AlperYaanik/STM32-Based-CAN-Bus-Communication-Interface/f401_mcp2515_node/f401_mcp2515_node.ioc

Mcu.UserName=STM32F401CCUx
PA10.Signal=USART1_RX
PA13.Signal=SYS_JTMS-SWDIO
PA14.Signal=SYS_JTCK-SWCLK
PA4.Signal=GPIO_Output
PA5.Signal=SPI1_SCK
PA6.Signal=SPI1_MISO
PA7.Signal=SPI1_MOSI
PA9.Signal=USART1_TX
PB0.GPIO_Label=MCP2515_INT
PB0.Signal=GPXTI0
PB6.Signal=I2C1_SCL
PB7.Signal=I2C1_SDA
PC13-ANTI_TAMP.Signal=GPIO_Output
