AlperYaanik/STM32-Based-CAN-Bus-Communication-Interface/f103_can_loopback/Core/Src/main.c

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
/* Includes ------------------------------------------------------------------*/
#include "main.h"
#include "can.h"
#include "usart.h"
#include "gpio.h"

/* USER CODE BEGIN Includes */
#include <stdio.h>
#include <string.h>
/* USER CODE END Includes */

/* USER CODE BEGIN PM */
#define CAN_TIMEOUT_MS 100
/* USER CODE END PM */


void SystemClock_Config(void);
/**
  * @brief  The application entry point.
  * @retval int
  */
int main(void)
{

  /* MCU Configuration--------------------------------------------------------*/

  /* Reset of all peripherals, Initializes the Flash interface and the Systick. */
  HAL_Init();

  /* Configure the system clock */
  SystemClock_Config();

  /* Initialize all configured peripherals */
  MX_GPIO_Init();
  MX_CAN_Init();
  MX_USART1_UART_Init();
  /* USER CODE BEGIN 2 */

  //Can Filter Configuration
    //Loopback Mode Filter Configuration and Selecting Filter Bank (0-13)
    CAN_FilterTypeDef canFilterConfig;
    canFilterConfig.FilterBank = 0;
    //ID Mask Mode (for easy usages , ID list for betwwen specified intervals) and 32-bit scale configuration (for standard and extended IDs)
    canFilterConfig.FilterMode = CAN_FILTERMODE_IDMASK;
    canFilterConfig.FilterScale = CAN_FILTERSCALE_32BIT;
    //Accept All Id (ie. 0x123<<5 for IMU sensor)
    canFilterConfig.FilterIdHigh = 0x0000;
    canFilterConfig.FilterIdLow= 0x0000;
    canFilterConfig.FilterMaskIdHigh = 0x0000;
    canFilterConfig.FilterMaskIdLow = 0x0000;
    //Convention, one FIFO is enough for loopback mode, so we can use FIFO0
    canFilterConfig.FilterFIFOAssignment = CAN_FILTER_FIFO0;
    //Must to ENABLE Filter Activation, otherwise the filter will not work
    canFilterConfig.FilterActivation = ENABLE;
    //Have to configure for Dual CAN board. STM32F103 has only one, but have to filled because of the structure.
    //So, we can use 14 for SlaveStartFilterBank (0-13 for Master, 14-27 for Slave)
    canFilterConfig.SlaveStartFilterBank = 14;
    //Error Handling (HAL_OK = 0, HAL_ERROR = 1, HAL_BUSY = 2, HAL_TIMEOUT = 3), important for debugging
    if (HAL_CAN_ConfigFilter(&hcan, &canFilterConfig) != HAL_OK)
    {
      Error_Handler();
    }
    //Start CAN Peripheral
    if(HAL_CAN_Start(&hcan)!=HAL_OK)
    {
      Error_Handler();
    }


    //Message Envelope Tx Configuration
    CAN_TxHeaderTypeDef TxHeader ={0};
    uint32_t TxMailbox;
    //We can send 8 bytes of data
    uint8_t TxData[8];
    //Standard ID (11 bits) for the message, 0x123 is a common ID for testing
    TxHeader.StdId = 0x123;
    //Extended ID (29 bits) is not used, so we can set it to 0
    TxHeader.ExtId = 0x00;
    //Standard ID is used, so we can set the IDE to CAN_ID_STD
    TxHeader.IDE = CAN_ID_STD;
    //Data Frame is used, so we can set the RTR to CAN_RTR_DATA
    TxHeader.RTR = CAN_RTR_DATA;
    //Selecting Bytes (Data Length Code), we send 8 bytes of data so we can set the DLC to 8
    TxHeader.DLC = 8;
    //Disable the Transmit Global Time, we don't need it for this example
    TxHeader.TransmitGlobalTime = DISABLE;
    //Data to be sent, we can fill the TxData array with some values
    TxData[0]=1;
    TxData[1]=2;
    TxData[2]=3;
    TxData[3]=4;
    TxData[4]=5;
    TxData[5]=6;
    TxData[6]=7;
    TxData[7]=8;


    //Message Envelope Rx Configuration
    CAN_RxHeaderTypeDef RxHeader ={0};
    //Received Bytes
    uint8_t RxData[8];

    //Create Tick Variable for Timeout Detection
    uint32_t tick = HAL_GetTick();
    //Create Message Variable for UART Message
    char msg[64];
  /* USER CODE END 2 */

  /* Infinite loop */
  /* USER CODE BEGIN WHILE */
  while (1)
  {

	   //Check how many mailboxes are free (returns 0-3), Use to tick for detecting timeout
	   tick= HAL_GetTick();
	   while(HAL_CAN_GetTxMailboxesFreeLevel(&hcan)==0)
	   {
	     if(HAL_GetTick()-tick>CAN_TIMEOUT_MS)
	     {
	       Error_Handler();
	     }
	   }
	   //Send the message
	   if (HAL_CAN_AddTxMessage(&hcan, &TxHeader, TxData, &TxMailbox) != HAL_OK)
	   {
	     Error_Handler();
	   }
	 //Check if the message is still pending in the mailbox
	   while(HAL_CAN_IsTxMessagePending(&hcan, TxMailbox));
	   //Wait until a message is received, Use to tick for detecting timeout
	   tick = HAL_GetTick();
	   while(HAL_CAN_GetRxFifoFillLevel(&hcan, CAN_RX_FIFO0)==0)
	   {
	     if(HAL_GetTick()-tick>CAN_TIMEOUT_MS)
	     {
	       Error_Handler();
	     }
	   }
	   //Read the frame
	   if(HAL_CAN_GetRxMessage(&hcan, CAN_RX_FIFO0, &RxHeader, RxData)!=HAL_OK)
	   {
	     Error_Handler();
	   }
	   //Transmit the received data over UART for debugging purposes
	   snprintf(msg, sizeof(msg),"Received Data: %d %d %d %d %d %d %d %d\r\n",
	    RxData[0], RxData[1], RxData[2], RxData[3], RxData[4], RxData[5], RxData[6], RxData[7]);
	   HAL_UART_Transmit(&huart1, (uint8_t*)msg, strlen(msg), HAL_MAX_DELAY);
	   //Wait 2 seconds for system operability
	   HAL_Delay(2000);
	   //Increase data value
	   TxData[0]++;

	   //Detect If UART is Working
	   //HAL_Delay(1000);
	   //char msg_2[] = "UART OK\r\n";
	   //HAL_UART_Transmit(&huart1, (uint8_t *)msg_2, strlen(msg_2), HAL_MAX_DELAY);

	   // Detect IF Led Is Working
	   //HAL_GPIO_TogglePin(GPIOC, GPIO_PIN_13);
	   //HAL_Delay(2000);
    /* USER CODE END WHILE */

    /* USER CODE BEGIN 3 */
  }
  /* USER CODE END 3 */
}

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
