AlperYaanik/STM32-Based-CAN-Bus-Communication-Interface/(commit log)

2026-08-01 Add MCP2515 CAN driver, SPI/USART peripherals; clean up build artifacts from VCS
    - Add MCP2515 CAN bus driver (mcp2515.c/h) under STM32CubeIDE/Drivers
    - Add SPI and USART peripheral init files (spi.c/h, usart.c/h)
    - Add HAL SPI and UART driver sources and headers
    - Update main.c, gpio.c, stm32f4xx_it.c for f401 MCP2515 loopback project
    - Update f103 main.c and .cproject
    - Remove Debug build artifacts, .mxproject, and .settings from VCS (already in .gitignore)
2026-08-01 Fix MCP2515 driver build errors and UART transmit bug
    - Add missing bitTiming8MHz/16MHz lookup tables for SetBitrate()
    - Fix MCP2515_SetLoopbackMode() return type: void → bool in header
    - Fix UART transmit: use snprintf + pointer cast instead of raw integer
    [main.c, mcp2515.c, mcp2515.h]
2026-08-01 Add incremental MCP2515 test suite with loopback verification
    - Add UART output for all test stages (mode read, write, status, config, bitrate, TX buffer, loopback)
    - Completed tests: SPI read/write, ReadStatus, ConfigMode, SetBitrate, LoadTXBuffer, full loopback RX
    - All tests passed successfully
2026-08-05 Add f103_node_sensor CAN node project and restore .gitignore
    Adds new STM32F103 sensor node project with CAN, I2C, and UART peripherals.
    Restores .gitignore to exclude IDE artifacts and build outputs.
2026-08-11 Add debug log module to f103_node_sensor and track dropped CAN packets
2026-08-12 Add MPU6050 driver and wire f103_node_sensor to transmit over CAN
    - mpu6050.c/h: init (wake + WHO_AM_I check) and burst accel/gyro read
    - main.c: drop loopback-era RX relay, poll IMU and send two CAN frames (accel/gyro)
    - can.c, stm32f1xx_it.c/h: remove unused/wrong CAN1_RX1 NVIC wiring
    - .project: register debug.c/mpu6050.c as build sources (fixes link errors)
    [main.c, mpu6050.c, mpu6050.h]
2026-09-12 Add shared CAN contract and fix blocking I2C timeouts in f103_node_sensor
    Introduce Core/Inc/can_protocol.h, the frame-format contract shared with the
    receiver node: CAN identifiers, DLC, bitrate, and CAN_PackAxes/CAN_UnpackAxes.
    main.c now calls CAN_PackAxes instead of open-coding the big-endian packing, so
    the pack and unpack sides cannot drift apart independently.
    Replace HAL_MAX_DELAY with a 100 ms timeout in all three MPU6050 I2C calls. With
    an infinite timeout an unresponsive sensor blocks forever, which makes the
    "read FAILED" branch in main.c unreachable and leaves the board looking dead
    rather than reporting the fault.
    Add a 100 ms settle delay after clearing the PWR_MGMT_1 SLEEP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
    [can_protocol.h, debug.h, main.c, mpu6050.c, mpu6050.h]
2026-09-12 Add f401_mcp2515_node, the MCP2515 receiver node
    Second node of the CAN link: an STM32F401 receives the IMU frames published by
    f103_node_sensor through an external MCP2515 controller over SPI and reports them
    over UART. It runs in normal mode rather than listen-only so that it also
    acknowledges frames, without which the sender cannot count any frame as sent.
    Carries the byte-identical copy of can_protocol.h and a debug/LOG module matching
    the one in f103_node_sensor.
    The MCP2515 driver from the loopback project is extended for real reception:
    - MCP2515_Receive checks the RX0IF/RX1IF flags in CANINTF before reading, and
    clears the flag afterwards with a bit-modify. The previous ReadRXBu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
2026-09-12 Document the repository and drop stray IDE artifacts
    Add a root README covering the architecture, the frame format, the hardware, and
    the engineering notes worth keeping: the 3V3 supply and its effect on the MCP2515
    SPI ceiling, why normal-mode entry has to be polled, why receive-buffer rollover
    is mandatory at this frame spacing, why the two controllers' sample points differ,
    and why the sender transmits one-shot.
    Add a README to each of the four projects describing its role in the incremental
    bring-up, its pin map and configuration, its expected output, and how to
    troubleshoot it. The two loopback projects are documented as deliberate steps
    rather than leftovers: each validates one layer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
2026-09-12 Add gyroscope bias calibration to the MPU6050 driver
    At rest the gyro reads about -3.7 deg/s on X, an uncalibrated zero-rate offset.
    Integrated into an angle that is 218 deg of drift per minute, so it has to be
    removed before the readings are useful for anything but raw logging.
    MPU6050_CalibrateGyro averages 512 samples spaced 5 ms apart and stores the
    result; MPU6050_ReadRaw subtracts it from every later gyro reading, saturating
    rather than wrapping so a large rate near full scale cannot flip sign. The
    accelerometer path and the CAN frame format are untouched, so the receiver needs
    no change.
    The measurement is refused if any axis moved more than ~7.6 deg/s peak to peak
    during the run. W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
    [main.c, mpu6050.c, mpu6050.h]
2026-09-12 Report calibration movement so mounting quality is visible
    MPU6050_GetGyroCalSpread exposes the peak-to-peak movement seen on each axis
    during the last calibration attempt, and main.c prints it whether the attempt
    succeeded or was refused.
    Calibration is a mechanical problem before it is a software one: a board held
    still by a finger, or pulled around by the spring force of its own jumper wires,
    cannot be calibrated well regardless of how many samples are averaged. Printing
    the movement turns the routine into a measurement of the setup itself, so a
    mounting change can be evaluated directly instead of guessed at.
    [main.c, mpu6050.c, mpu6050.h]
2026-09-12 Instrument both nodes to measure achieved rate and lost frames
    Groundwork for deciding whether an RTOS is warranted here. The current design
    cannot be judged by watching lines scroll past, so both nodes now report what
    they actually accomplished once a second.
    The sender counts samples and prints the rate it achieved against the rate it
    requested. HAL_Delay waits its interval on top of the work, so the real period
    is always longer than SAMPLE_PERIOD_MS - and it varies, because a longer line of
    digits takes longer to leave the UART. CAN_SendFrame now returns a bool so
    failures are counted rather than only logged.
    The receiver counts frames and reads EFLG_RXnOVR, which the MCP2515 sets when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
    [main.c, mcp2515.c, mcp2515.h]
2026-09-12 Batch MCP2515 SPI into one transaction per instruction
    The rate experiment showed the receiver stuck at 547 frames/s even with all
    per-frame printing disabled, so the UART was no longer the limit. Reading one
    frame cost 1.83 ms across roughly 40 separate single-byte
    HAL_SPI_TransmitReceive calls, of which only 82 us was the SPI transfer itself.
    The other 95% was per-call HAL overhead on a 16 MHz core - a driver problem, and
    specifically not one an RTOS would fix.
    Every access now issues its instruction as one multi-byte transfer inside a
    single CS-low window. The receive path additionally uses the instructions meant
    for it: READ STATUS reports both receive flags in two bytes, so the idle ca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
    [main.c, mcp2515.c, mcp2515.h]
2026-09-13 Avoid dividing by zero when the sender runs free
    The once-a-second rate report computed the requested rate as
    10000 / SAMPLE_PERIOD_MS. With the period set to 0 for the flat-out rate
    experiment, that is a division by zero - undefined behaviour in C. On this
    Cortex-M3 the divide-by-zero trap is disabled, so it silently produced 0 and
    printed "of 0.0 Hz"; GCC flags it with -Wdiv-by-zero at that setting.
    A zero period now selects a separate report that states the loop is
    free-running instead of comparing against a requested rate that does not
    exist.
    [main.c]
2026-09-13 Break receiver statistics down by identifier and receive buffer
    Under saturation the receiver passes one message type several times more often
    than the other, even though the sender emits accel and gyro in equal numbers and
    reports no transmit failures. The existing statistics could not show this: they
    gave a total frame rate and derived "samples/s" as half of it, which assumes
    exactly the balance that had stopped holding.
    The once-a-second line now reports accel, gyro and unexpected frames separately,
    which buffer each frame was taken from, and the RX0OVR and RX1OVR overflow bits
    as separate counts. MCP2515_Frame_t gains a buffer field so reception can report
    where a frame came from.
    MCP2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
    [main.c, mcp2515.c, mcp2515.h]
2026-09-13 Make the idle diagnostic tell a quiet bus from a dead SPI link
    When no frame arrives for a second the receiver prints CANSTAT, EFLG, TEC and
    REC. On a healthy idle bus all four read 0x00 - but so do they when the SPI link
    to the MCP2515 has failed, since a disconnected MISO line reads as zeros. The
    line therefore could not distinguish "nobody is transmitting" from "the
    receiver can no longer hear its own controller", which is the first question to
    answer when frames stop.
    CNF2 is now read back as well. It was written with a known non-zero value
    during bring-up, so a matching read proves the link is alive and the zeros
    elsewhere are real; a zero read means the other fields are meaningless.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
    [main.c]
2026-09-13 Add a knob to swap the order of each sample's two CAN frames
    Under receiver saturation the gyro frame survives about 90% of the time even
    though both are sent equally often, and swapping the receiver's buffer
    servicing order did not change that. The remaining question is whether the
    bias follows a frame's position in the pair or its identifier.
    SEND_GYRO_FIRST hands the gyro frame to the controller before the accel frame.
    The bus is idle when the first is queued, so the order on the wire follows the
    call order: if accel now dominates the effect is timing; if gyro still does, it
    is tied to the identifier.
    [main.c]
2026-09-13 Document the measured results and restore experiment defaults
    The rate and loss experiments are complete, so their results move into the
    root README and the knobs go back to normal operation: 100 ms sampling with
    logging on both nodes, natural buffer servicing order and natural transmit
    order.
    The README gains a Measured performance section: where the bare-metal design
    breaks, the separation between the driver bottleneck (fixed by batching SPI)
    and the logging-in-the-data-path bottleneck (the part an RTOS addresses), and
    the finding that under saturation survival follows a frame's position in each
    pair rather than its identifier - with the microscopic mechanism recorded as an
    open question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
    [main.c]
2026-09-15 Enable FreeRTOS in CubeMX for the receiver node
    Configuration only; the application still runs its bare-metal loop until the
    tasks are written. The baseline this replaces is tagged v1-bare-metal.
    - PB0 becomes EXTI0, falling edge with pull-up, labelled MCP2515_INT, so the
    MCP2515 can announce received frames instead of being polled. Polling at the
    1 ms tick would leave zero margin: about two frames arrive per millisecond
    at the measured rate and the controller buffers only two.
    - EXTI0 runs at NVIC priority 6, below configLIBRARY_MAX_SYSCALL_INTERRUPT_
    PRIORITY (5), as required for an ISR that calls FreeRTOS FromISR APIs.
    - The HAL timebase moves from SysTick to TIM11. FreeRTOS owns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
    [f401_mcp2515_node.ioc, main.c]
2026-09-15 Move the receiver onto FreeRTOS tasks
    The bare-metal receiver printed each frame from the same loop that drained the
    MCP2515, so a 3.5 ms UART line left the controller's two-frame buffer to
    overflow. With the sender at 2019 frames/s and logging on, it received 249.
    Reception and printing now run in separate tasks.
    CanRxTask (high priority) is the only code that talks to the MCP2515. It sleeps
    until the INT pin wakes it through a task notification from the EXTI0 callback,
    reads until both receive buffers are empty, counts every frame, and hands a copy
    to LogTask's queue with a zero timeout. It never waits on that queue: blocking
    there would let the controller overflow while the UART caught u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
2026-09-15 Record the FreeRTOS receiver measurements
    With the sender at 2019 frames/s and per-frame logging on, the FreeRTOS receiver
    takes every frame (2022 frames/s measured) with zero controller overflow, against
    249 frames/s and 248 overflows per second for the bare-metal receiver under the
    same conditions. The loss moved into counted log lines as designed, and the
    accel/gyro starvation disappeared: both receive buffers are drained on every
    interrupt and the two message types arrive one-for-one.
    The run also showed the next limit. The report meant for once a second arrived
    every 4-5 seconds with a single frame line between reports, because CanRxTask and
    its interrupts consumed nearly all of the 16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
2026-09-15 Measure receiver CPU load with FreeRTOS run-time statistics
    The FreeRTOS receiver kept every frame at 2019 frames/s, but its once-a-second
    report stretched to 4-5 s, which pointed to the CPU being nearly saturated. That
    was an inference from late output. This makes it a measurement.
    configGENERATE_RUN_TIME_STATS is enabled in the FreeRTOSConfig.h user block,
    which CubeMX preserves across regeneration, because the clock behind it is
    application code. The kernel charges each task for the time between context
    switches, so it needs a counter far finer than the 1 ms tick. The Cortex-M4
    DWT cycle counter provides one without a timer peripheral or an interrupt.
    CYCCNT is 32 bits and wraps every ~2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
2026-09-16 Cut a received pair from 6 SPI transactions to 4
    Run-time statistics showed CanRxTask consuming ~90% of the core at the
    sender's full rate, with three of six per-pair SPI transactions spent on
    READ STATUS: one before each buffer read, plus a closing check that always
    came back empty once both frames were taken.
    MCP2515_Receive now caches the flags a READ STATUS reports across calls. The
    sender's two frames usually land together by the time this task runs, so one
    status read answers for the whole pair instead of one per frame. The closing
    "anything else?" check reads the INT pin instead of querying the bus: INT is
    defined as exactly the OR of the two receive flags, so a high reading proves
    t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
2026-09-16 Reset sender to normal operation and add MIT license
    f103_node_sensor's main.c had been left at the T3 experiment's knob values
    (free-running, logging off) since a session that never restored them. Back to
    the defaults a clone should build with: 100 ms sampling, per-sample logging on.
    Add a root LICENSE (MIT) covering the project's own code, with a note on the
    vendored third-party code that keeps its own terms - ST's CMSIS headers
    (Apache 2.0) and HAL drivers (BSD-3-Clause), the FreeRTOS kernel (MIT). Verified
    against the actual LICENSE.txt/LICENSE files already present in the tree rather
    than assumed. Root README links to it and lists what is measured-done versus
    still planned.
    Co-Authore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
2026-09-16 Reserve README slots for a hardware photo and a demo GIF
    docs/media/ holds the images the root README will link to, with the exact
    filenames, what each should show, and a suggested GIF workflow written out so
    filling them in later is a drop-and-rename rather than a decision.
    The README references are commented out (<!-- -->) rather than live <img>
    tags, so the page has no broken-image icon until the files actually exist -
    uncomment both lines in README.md once hardware-setup.jpg and demo.gif are
    added to docs/media/.
2026-09-16 Correct the SPI reduction's predicted effect with the measured one
    Hardware measurement (C1: sender free-running, receiver logging off) landed
    short of the roughly-one-third drop in rx the transaction-count estimate
    predicted: rx went 89.8% -> 82.8%, not to ~60%. idle went 0.0% -> 13.0%,
    which is the change worth keeping - real headroom where there had been none.
    The wakeups counter explains the gap: it lands almost 1:1 with the accel
    frame count rather than at half of it, meaning the status-flag cache rarely
    gets to answer for a whole pair as designed. The sender leaves only
    ~220-250 us between a pair's two frames, and a single SPI HAL call here
    costs about 148 us, so status+one buffer rea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
2026-09-16 Add the hardware photo and demo GIF, wire up the README links
    Files added under docs/media/ per the filenames docs/media/README.md
    specified; both README references uncommented now that the images exist.
    The GIF (800x1010, 10 s, ~7 MB) is heavier than ideal for an embedded README
    asset - noted for later trimming, not blocking here since the content is
    correct: it shows the live [rx]/[os]/[cpu] report lines and decoded
    ACCEL/GYRO frames, which is what it was meant to prove.
2026-09-16 Replace the hardware photo and GIF with better captures
    Photo: boards mounted and labelled, wiring visibly tidied and taped down
    instead of loose on the desk - correlates directly with the architecture
    diagram now. GIF: 7 MB -> 1.2 MB (500x757, 4 s, 28 frames), same content
    (live [rx]/[os]/[cpu] report and decoded frames), loads without dragging
    down the README.
