AlperYaanik/STM32-Based-CAN-Bus-Communication-Interface/(notices)

Notices in the files:
f103_can_loopback/Core/Src/main.c:
Copyright (c) 2026 STMicroelectronics.
All rights reserved.
This software is licensed under terms that can be found in the LICENSE file
